weiiwang01/picard/case/PiCard-Box.step

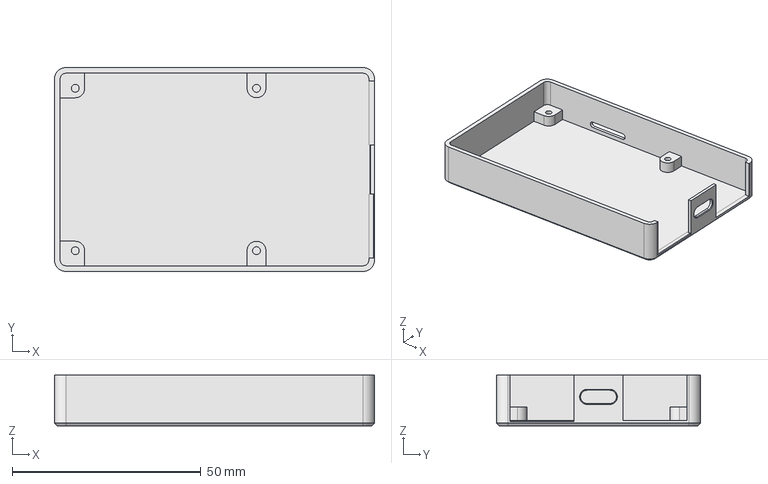
[picture p1: CAD file, 2024-05-11]
case/PiCard-Box.step
84.8 x 54.0 x 13.5 mm
