weiiwang01/picard/case/PiCard-Lid.step

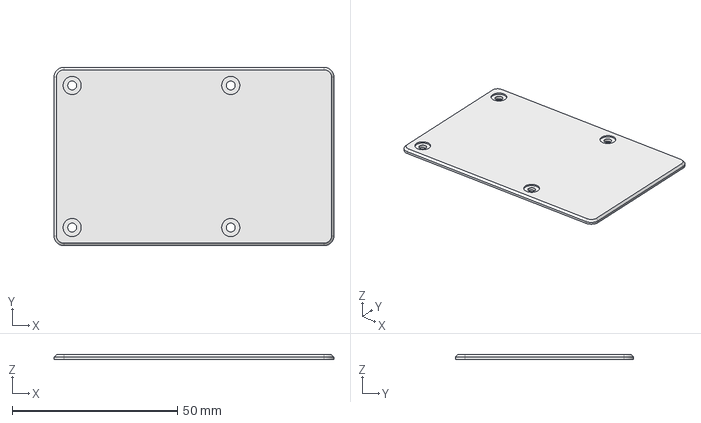
[picture p2: CAD file, 2024-05-11]
case/PiCard-Lid.step
84.8 x 54.0 x 1.50 mm
