weiiwang01/picard/case/PiCard-Box.pdf

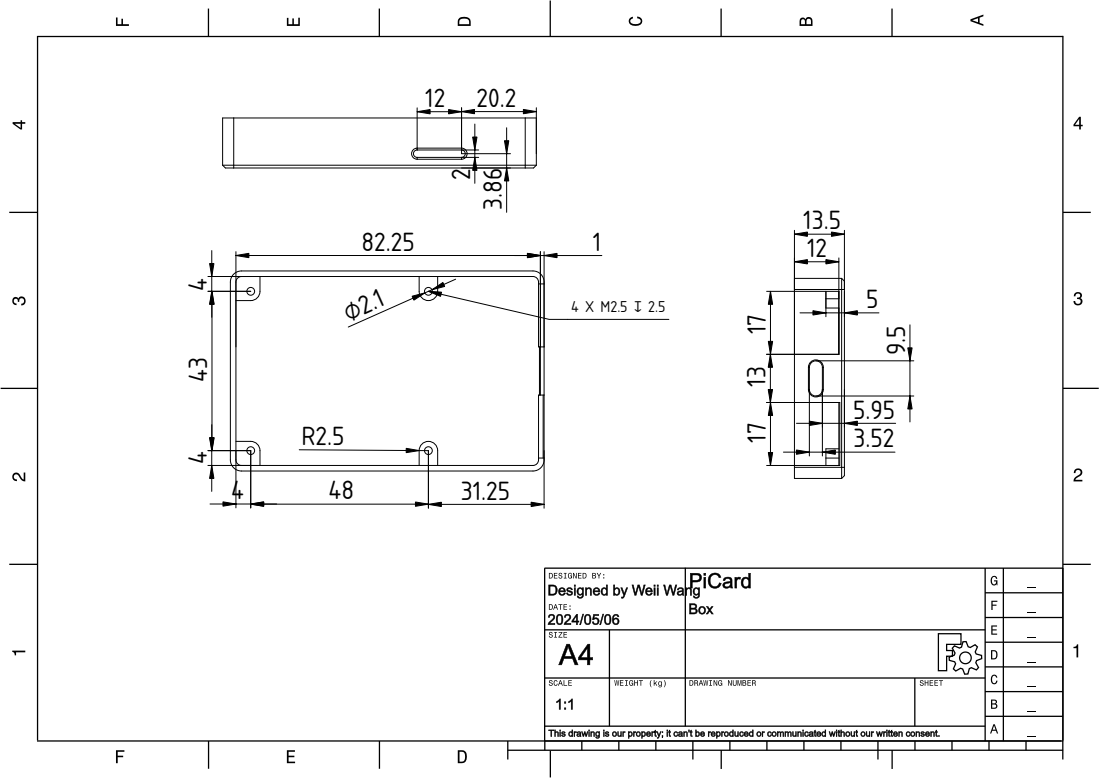
[picture p3: page 1]
