weiiwang01/picard/case/PiCard-Lid.pdf

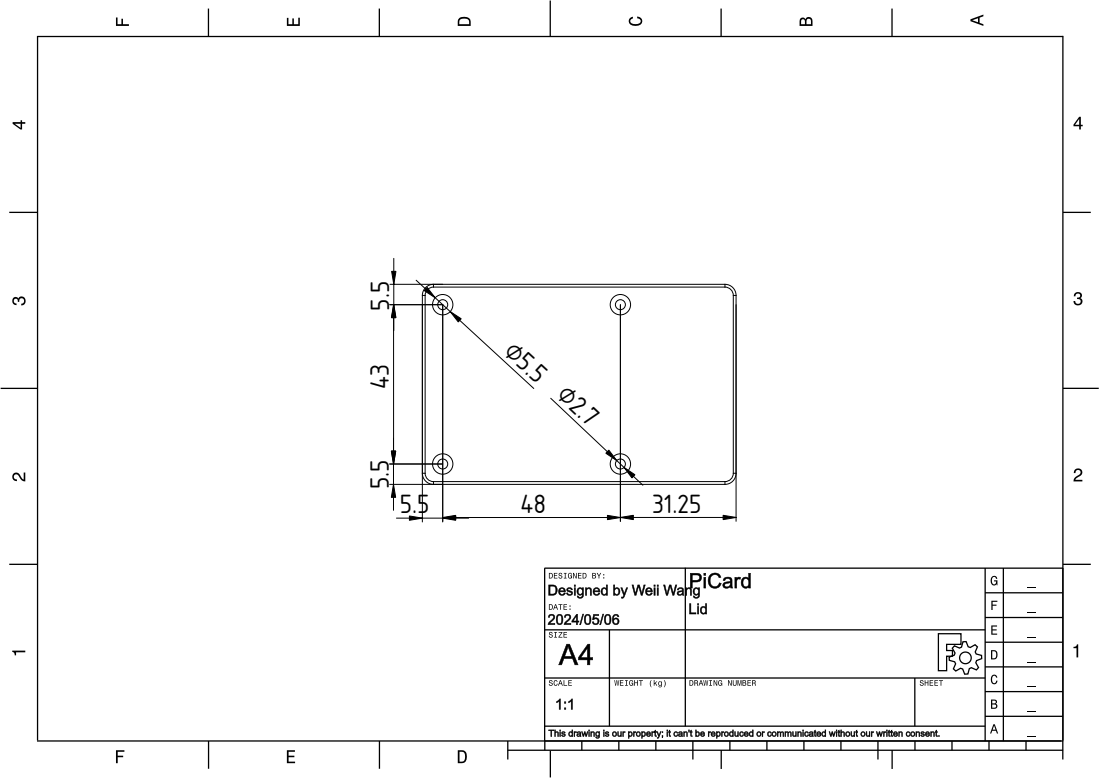
[picture p4: page 1]
