weiiwang01/picard/PiCard.kicad_pcb

## KiCad design PiCard.kicad_pcb (2024-10-13)

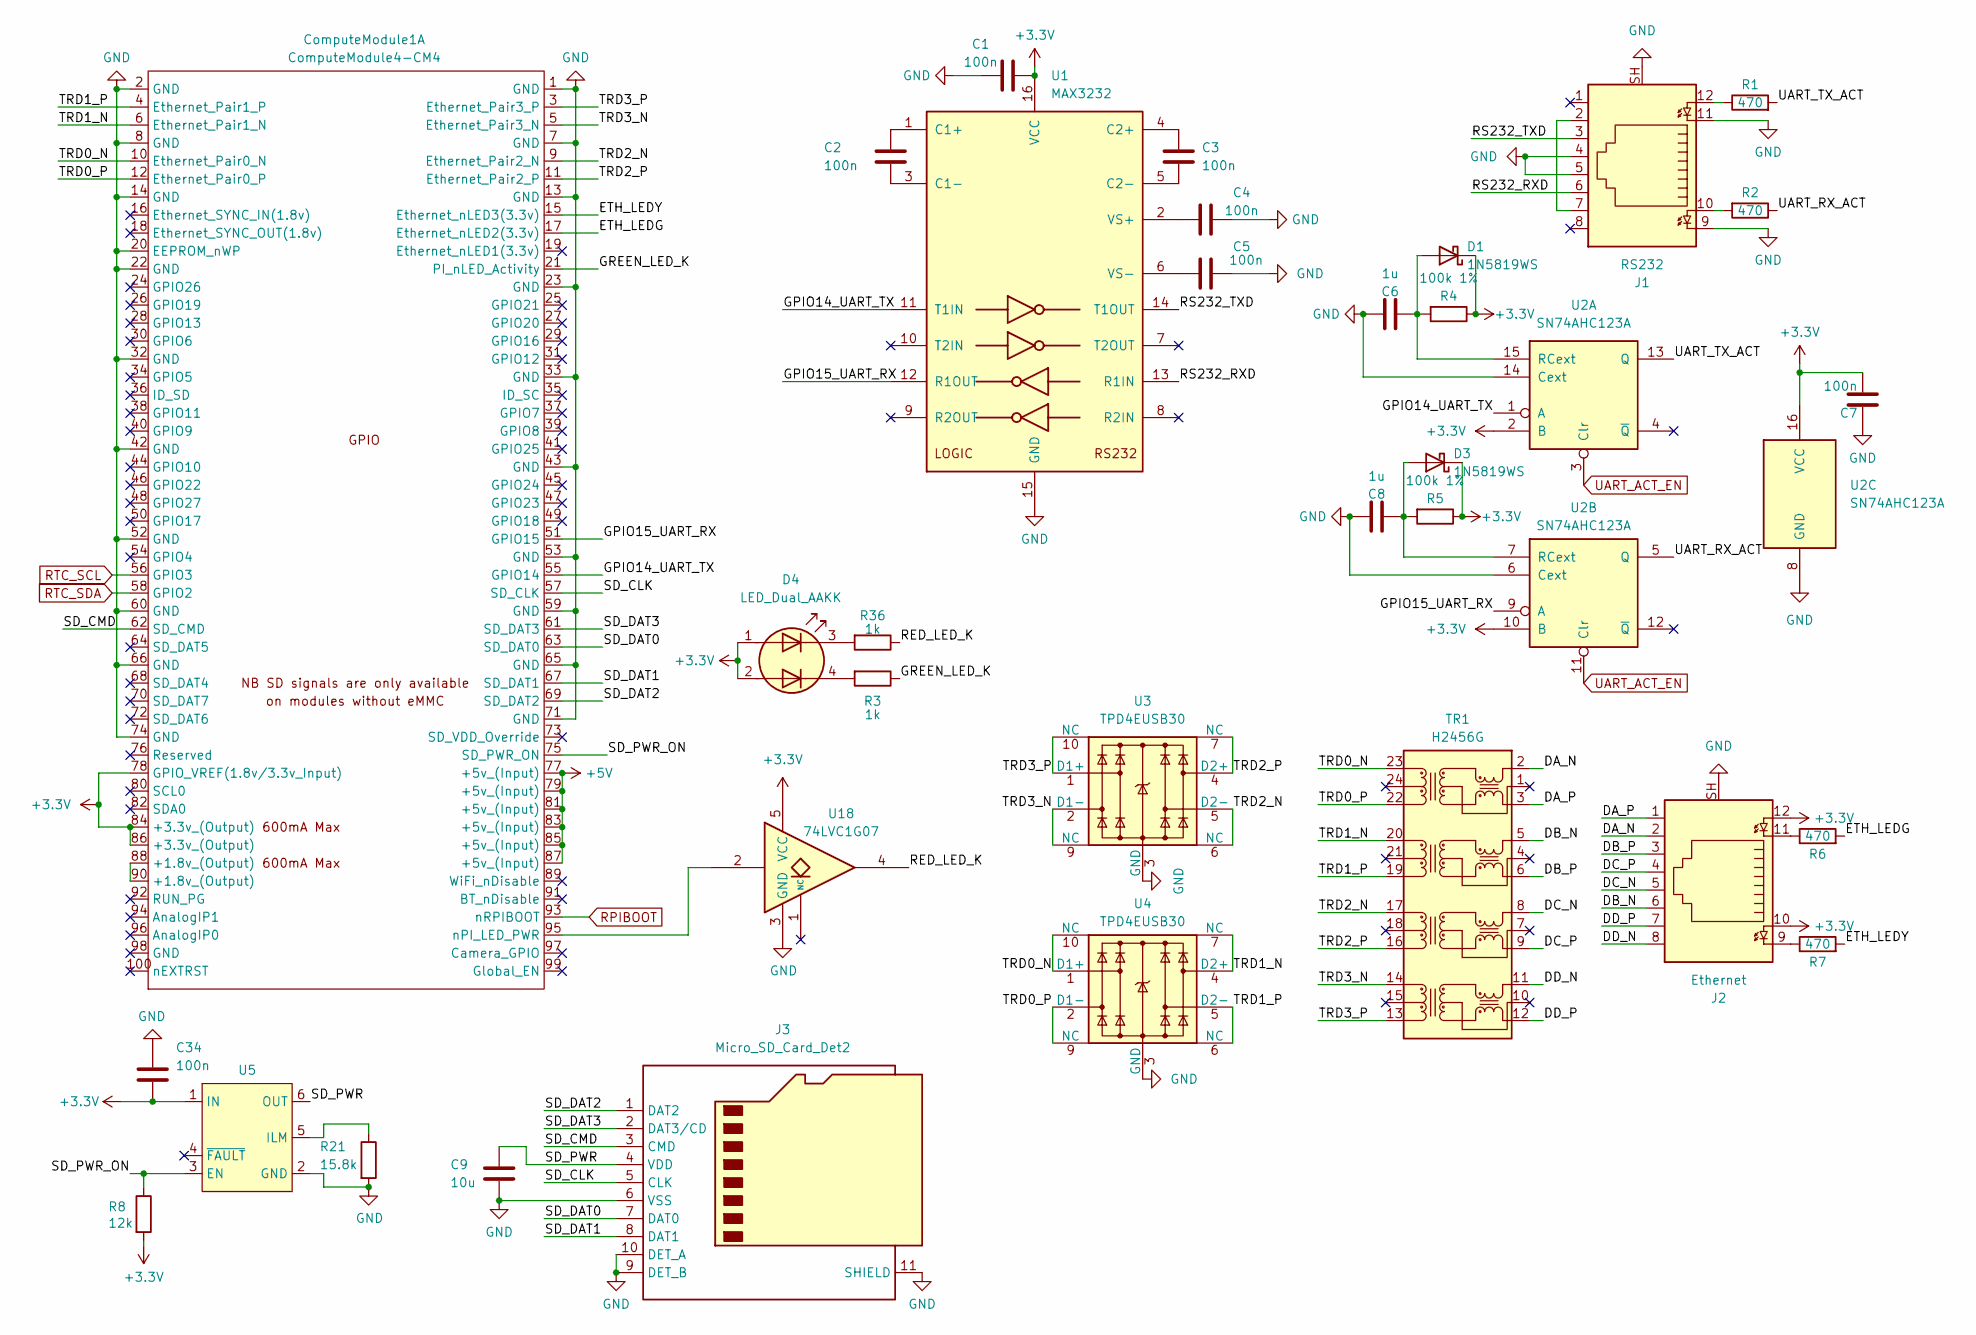
[picture p5: schematic module_a.kicad_sch]

Parts:
C1, C2, C3, C4, C5, C7, C34: 100n; C_0402_1005Metric; MPN CL05B104KB54PNC; LCSC C307331
C6, C8: 1u; C_0603_1608Metric; MPN CL10A105KB8NNNC; LCSC C15849
C9: 10u; C_0805_2012Metric; MPN CL21A106KAYNNNE; LCSC C15850
ComputeModule1: ComputeModule4-CM4; Raspberry-Pi-4-Compute-Module
D1, D3: 1N5819WS; D_SOD-323; MPN 1N5819WS; LCSC C191023
D4: LED_Dual_AAKK; LED-ARRAY-SMD_4P-L3.0-W1.5-L-FD; MPN MHS110URGCT; LCSC C473813
J1: RS232; RJ45-TH_RJ45-005-202-11; MPN RJ45-005-202-11; LCSC C501462
J2: Ethernet; RJ45-TH_RJ45-005-202-11; MPN RJ45-005-202-11; LCSC C7421405
J3: Micro_SD_Card_Det2; TF-SMD_503398-1892; MPN TF-108-ARP10; LCSC C5174683
R1, R2, R6, R7: 470; R_0402_1005Metric; MPN 0402WGF4700TCE; LCSC C25117
R3, R36: 1k; R_0402_1005Metric; MPN 0402WGF1001TCE; LCSC C11702
R4, R5: 100k 1%; R_0402_1005Metric; MPN 0402WGF1003TCE; LCSC C25741
R8: 12k; R_0402_1005Metric; MPN 0402WGF1202TCE; LCSC C25752
R21: 15.8k; R_0402_1005Metric; MPN AC0402FR-0715K8L; LCSC C226795
TR1: H2456G; XFMR-SMD-24_L16.6-W9.0-LS9.6-BL; MPN H2456G; LCSC C5464750
U1: MAX3232; TSSOP-16_4.4x5mm_P0.65mm; MPN MAX3232EEUE+T; LCSC C965425
U2: SN74AHC123A; TSSOP-16_4.4x5mm_P0.65mm; MPN SN74AHC123APWR; LCSC C2869599
U3, U4: TPD4EUSB30; USON-10_2.5x1.0mm_P0.5mm; MPN TPD4EUSB30DQAR; LCSC C90627
U5: SOT-23-6; MPN TPS2553DDBVR; LCSC C521201
U18: 74LVC1G07; SOT-353_SC-70-5; MPN SN74LVC1G07DCKR; LCSC C7830

Connections:
+3.3V: C1.2, C7.2, C34.2, ComputeModule1.78 (GPIO_VREF(1.8v/3.3v_Input)), ComputeModule1.84 (+3.3v_(Output)), ComputeModule1.86 (+3.3v_(Output)), D1.1 (K), D3.1 (K), D4.1 (A1), D4.2 (A2), J2.10, J2.12, R4.1, R5.1, R8.2, U1.16 (VCC), U2.2 (B), U2.10 (B), U2.16 (VCC), U5.1 (IN), U18.5 (VCC); also elsewhere on the board
+5V: ComputeModule1.77 (+5v_(Input)), ComputeModule1.79 (+5v_(Input)), ComputeModule1.81 (+5v_(Input)), ComputeModule1.83 (+5v_(Input)), ComputeModule1.85 (+5v_(Input)), ComputeModule1.87 (+5v_(Input)); also elsewhere on the board
/Module A/DA_N: J2.2, TR1.2 (MX1+)
/Module A/DA_P: J2.1, TR1.3 (MX1-)
/Module A/DB_N: J2.6, TR1.5 (MX2+)
/Module A/DB_P: J2.3, TR1.6 (MX2-)
/Module A/DC_N: J2.5, TR1.8 (MX3+)
/Module A/DC_P: J2.4, TR1.9 (MX3-)
/Module A/DD_N: J2.8, TR1.11 (MX4+)
/Module A/DD_P: J2.7, TR1.12 (MX4-)
/Module A/ETH_LEDG: ComputeModule1.17 (Ethernet_nLED2(3.3v)), R6.2
/Module A/ETH_LEDY: ComputeModule1.15 (Ethernet_nLED3(3.3v)), R7.2
/Module A/GPIO14_UART_TX: ComputeModule1.55 (GPIO14), U1.11 (T1IN), U2.1 (A)
/Module A/GPIO15_UART_RX: ComputeModule1.51 (GPIO15), U1.12 (R1OUT), U2.9 (A)
/Module A/GREEN_LED_K: ComputeModule1.21 (PI_nLED_Activity), R3.1
/Module A/RED_LED_K: R36.1, U18.4
/Module A/RS232_RXD: J1.6, U1.13 (R1IN)
/Module A/RS232_TXD: J1.3, U1.14 (T1OUT)
/Module A/SD_CLK: ComputeModule1.57 (SD_CLK), J3.5 (CLK)
/Module A/SD_CMD: ComputeModule1.62 (SD_CMD), J3.3 (CMD)
/Module A/SD_DAT0: ComputeModule1.63 (SD_DAT0), J3.7 (DAT0)
/Module A/SD_DAT1: ComputeModule1.67 (SD_DAT1), J3.8 (DAT1)
/Module A/SD_DAT2: ComputeModule1.69 (SD_DAT2), J3.1 (DAT2)
/Module A/SD_DAT3: ComputeModule1.61 (SD_DAT3), J3.2 (DAT3/CD)
/Module A/SD_PWR: C9.1, J3.4 (VDD), U5.6 (OUT)
/Module A/SD_PWR_ON: ComputeModule1.75 (SD_PWR_ON), R8.1, U5.3 (EN)
/Module A/TRD0_N: ComputeModule1.10 (Ethernet_Pair0_N), TR1.23 (TD1+), U4.1 (D1+), U4.10 (NC)
/Module A/TRD0_P: ComputeModule1.12 (Ethernet_Pair0_P), TR1.22 (TD1-), U4.2 (D1-), U4.9 (NC)
/Module A/TRD1_N: ComputeModule1.6 (Ethernet_Pair1_N), TR1.20 (TD2+), U4.4 (D2+), U4.7 (NC)
/Module A/TRD1_P: ComputeModule1.4 (Ethernet_Pair1_P), TR1.19 (TD2-), U4.5 (D2-), U4.6 (NC)
/Module A/TRD2_N: ComputeModule1.9 (Ethernet_Pair2_N), TR1.17, U3.5 (D2-), U3.6 (NC)
/Module A/TRD2_P: ComputeModule1.11 (Ethernet_Pair2_P), TR1.16 (TD3-), U3.4 (D2+), U3.7 (NC)
/Module A/TRD3_N: ComputeModule1.5 (Ethernet_Pair3_N), TR1.14 (TD4+), U3.2 (D1-), U3.9 (NC)
/Module A/TRD3_P: ComputeModule1.3 (Ethernet_Pair3_P), TR1.13 (TD4-), U3.1 (D1+), U3.10 (NC)
/Module A/UART_RX_ACT: R2.1, U2.5 (Q)
/Module A/UART_TX_ACT: R1.2, U2.13 (Q)
GND: C1.1, C4.2, C5.2, C6.2, C7.1, C8.2, C9.2, C34.1, ComputeModule1.1 (GND), ComputeModule1.2 (GND), ComputeModule1.7 (GND), ComputeModule1.8 (GND), ComputeModule1.13 (GND), ComputeModule1.14 (GND), ComputeModule1.20 (EEPROM_nWP), ComputeModule1.22 (GND), ComputeModule1.23 (GND), ComputeModule1.32 (GND), ComputeModule1.33 (GND), ComputeModule1.42 (GND), ComputeModule1.43 (GND), ComputeModule1.52 (GND), ComputeModule1.53 (GND), ComputeModule1.59 (GND), ComputeModule1.60 (GND), ComputeModule1.65 (GND), ComputeModule1.66 (GND), ComputeModule1.71 (GND), ComputeModule1.74 (GND), J1.4, J1.5, J1.9, J1.11, J1.SH, J2.SH, J3.6 (VSS), J3.9 (DET_B), J3.10 (DET_A), J3.11 (SHIELD), R21.2, U1.15 (GND), U2.6 (Cext), U2.8 (GND), U2.14 (Cext), U3.3 (GND), U3.8 (GND), U4.3 (GND), U4.8 (GND), U5.2 (GND), U18.3 (GND); also elsewhere on the board
unnamed: ComputeModule1.88 (+1.8v_(Output)), ComputeModule1.90 (+1.8v_(Output))
unnamed: ComputeModule1.95 (nPI_LED_PWR), U18.2
unnamed: C6.1, D1.2 (A), R4.2, U2.15 (RCext)
unnamed: C8.1, D3.2 (A), R5.2, U2.7 (RCext)
unnamed: D4.3 (K1), R36.2
unnamed: D4.4 (K2), R3.2
unnamed: J1.2, J1.7
unnamed: J1.10, R2.2
unnamed: J1.12, R1.1
unnamed: J2.9, R7.1
unnamed: J2.11, R6.1
unnamed: C2.1, U1.1 (C1+)
unnamed: C2.2, U1.3 (C1-)
unnamed: C3.1, U1.4 (C2+)
unnamed: C3.2, U1.5 (C2-)
unnamed: C4.1, U1.2 (VS+)
unnamed: C5.1, U1.6 (VS-)
unnamed: R21.1, U5.5 (ILM)
RPIBOOT: ComputeModule1.93 (nRPIBOOT); also elsewhere on the board
RTC_SCL: ComputeModule1.56 (GPIO3); also elsewhere on the board
RTC_SDA: ComputeModule1.58 (GPIO2); also elsewhere on the board
UART_ACT_EN: U2.3 (Clr), U2.11 (Clr); also elsewhere on the board

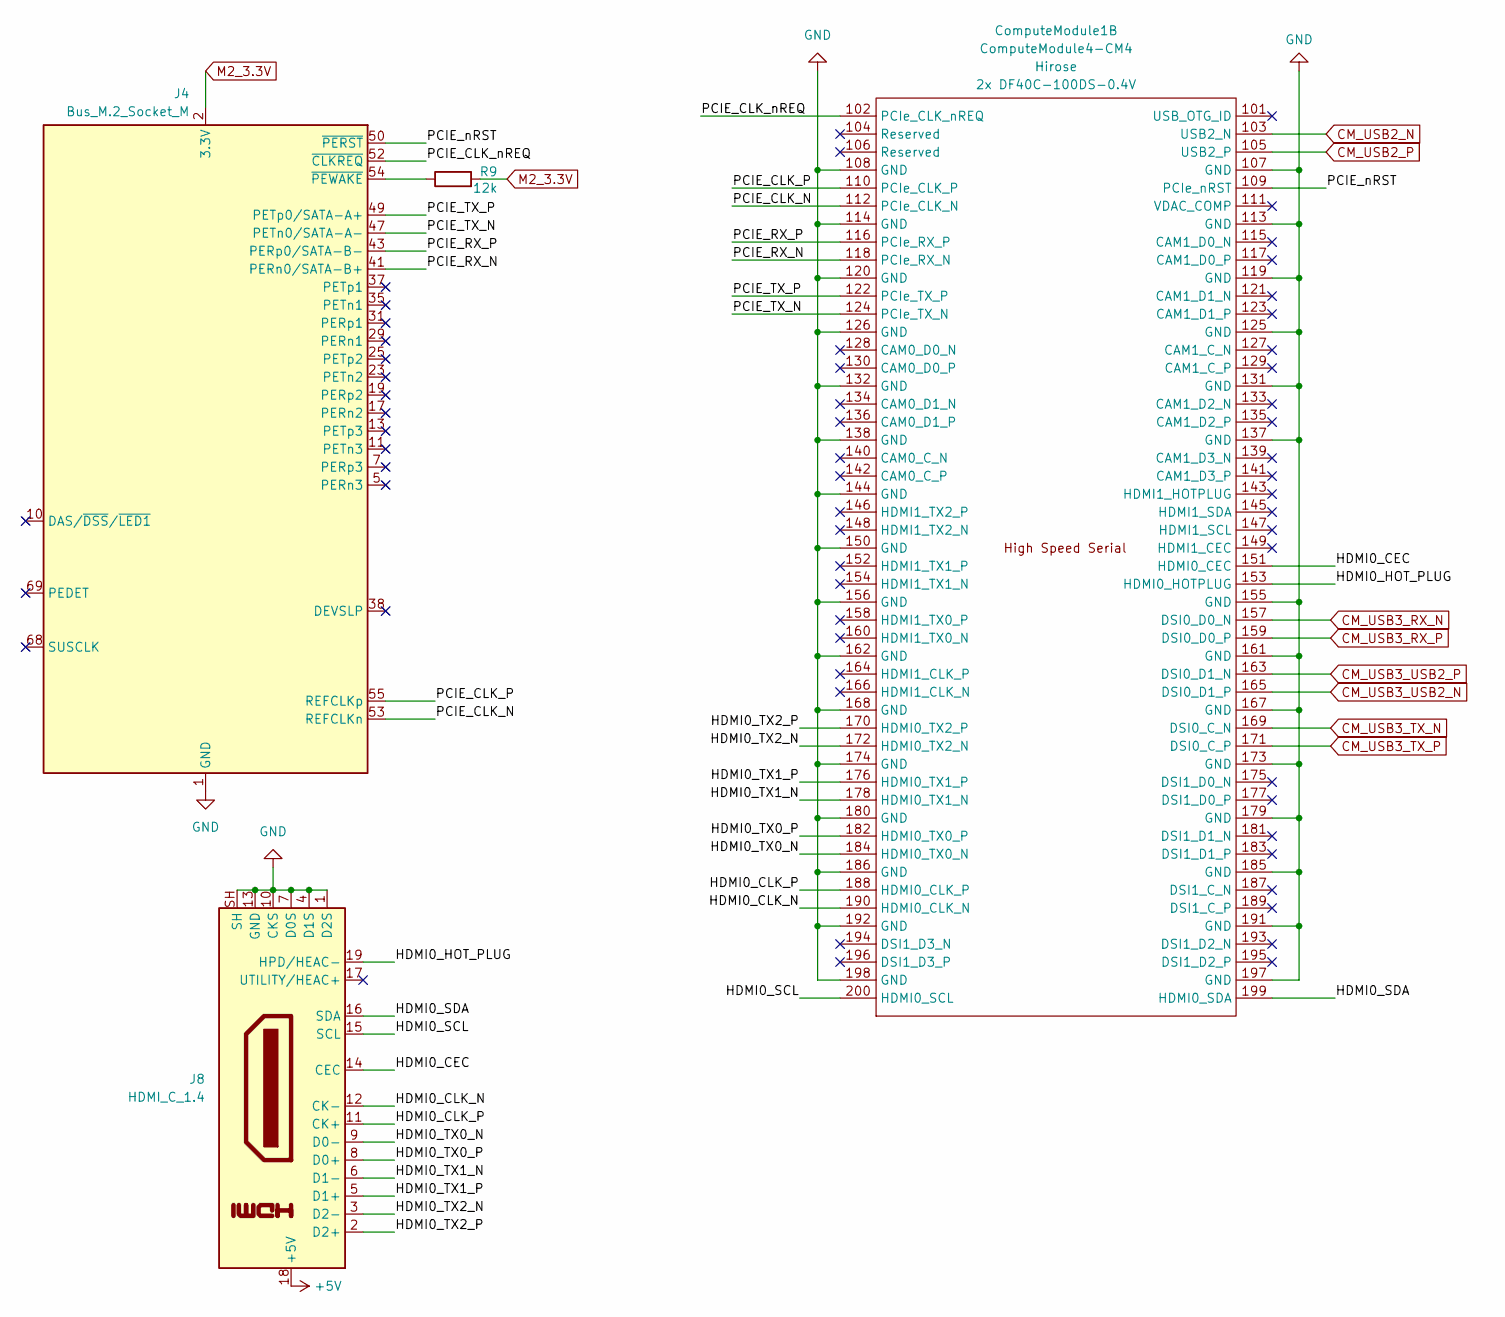
[picture p6: schematic module_b.kicad_sch]

Parts:
ComputeModule1: ComputeModule4-CM4; Raspberry-Pi-4-Compute-Module
J4: Bus_M.2_Socket_M; CONN-SMD_APCI0146-P001A; MPN APCI0146-P001A; LCSC C841645
J8: HDMI_C_1.4; HDMI-SMD_19P-P0.40-H-F_HDMI-519S; MPN HDMI-519S; LCSC C183605
R9: 12k; R_0402_1005Metric; MPN 0402WGF1202TCE; LCSC C25752

Connections:
+5V: J8.18 (+5V); also elsewhere on the board
/Module B/HDMI0_CEC: ComputeModule1.151 (HDMI0_CEC), J8.14 (CEC)
/Module B/HDMI0_CLK_N: ComputeModule1.190 (HDMI0_CLK_N), J8.12 (CK-)
/Module B/HDMI0_CLK_P: ComputeModule1.188 (HDMI0_CLK_P), J8.11 (CK+)
/Module B/HDMI0_HOT_PLUG: ComputeModule1.153 (HDMI0_HOTPLUG), J8.19 (HPD/HEAC-)
/Module B/HDMI0_SCL: ComputeModule1.200 (HDMI0_SCL), J8.15 (SCL)
/Module B/HDMI0_SDA: ComputeModule1.199 (HDMI0_SDA), J8.16 (SDA)
/Module B/HDMI0_TX0_N: ComputeModule1.184 (HDMI0_TX0_N), J8.9 (D0-)
/Module B/HDMI0_TX0_P: ComputeModule1.182 (HDMI0_TX0_P), J8.8 (D0+)
/Module B/HDMI0_TX1_N: ComputeModule1.178 (HDMI0_TX1_N), J8.6 (D1-)
/Module B/HDMI0_TX1_P: ComputeModule1.176 (HDMI0_TX1_P), J8.5 (D1+)
/Module B/HDMI0_TX2_N: ComputeModule1.172 (HDMI0_TX2_N), J8.3 (D2-)
/Module B/HDMI0_TX2_P: ComputeModule1.170 (HDMI0_TX2_P), J8.2 (D2+)
/Module B/PCIE_CLK_N: ComputeModule1.112 (PCIe_CLK_N), J4.53 (REFCLKn)
/Module B/PCIE_CLK_P: ComputeModule1.110 (PCIe_CLK_P), J4.55 (REFCLKp)
/Module B/PCIE_CLK_nREQ: ComputeModule1.102 (PCIe_CLK_nREQ), J4.52 (~CLKREQ)
/Module B/PCIE_RX_N: ComputeModule1.118 (PCIe_RX_N), J4.41 (PERn0/SATA-B+)
/Module B/PCIE_RX_P: ComputeModule1.116 (PCIe_RX_P), J4.43 (PERp0/SATA-B-)
/Module B/PCIE_TX_N: ComputeModule1.124 (PCIe_TX_N), J4.47 (PETn0/SATA-A-)
/Module B/PCIE_TX_P: ComputeModule1.122 (PCIe_TX_P), J4.49 (PETp0/SATA-A+)
/Module B/PCIE_nRST: ComputeModule1.109 (PCIe_nRST), J4.50 (~PERST)
CM_USB2_N: ComputeModule1.103 (USB2_N); also elsewhere on the board
CM_USB2_P: ComputeModule1.105 (USB2_P); also elsewhere on the board
CM_USB3_RX_N: ComputeModule1.157 (DSI0_D0_N); also elsewhere on the board
CM_USB3_RX_P: ComputeModule1.159 (DSI0_D0_P); also elsewhere on the board
CM_USB3_TX_N: ComputeModule1.169 (DSI0_C_N); also elsewhere on the board
CM_USB3_TX_P: ComputeModule1.171 (DSI0_C_P); also elsewhere on the board
CM_USB3_USB2_N: ComputeModule1.165 (DSI0_D1_P); also elsewhere on the board
CM_USB3_USB2_P: ComputeModule1.163 (DSI0_D1_N); also elsewhere on the board
GND: ComputeModule1.107 (GND), ComputeModule1.108 (GND), ComputeModule1.113 (GND), ComputeModule1.114 (GND), ComputeModule1.119 (GND), ComputeModule1.120 (GND), ComputeModule1.125 (GND), ComputeModule1.126 (GND), ComputeModule1.131 (GND), ComputeModule1.132 (GND), ComputeModule1.137 (GND), ComputeModule1.138 (GND), ComputeModule1.144 (GND), ComputeModule1.150 (GND), ComputeModule1.155 (GND), ComputeModule1.156 (GND), ComputeModule1.161 (GND), ComputeModule1.162 (GND), ComputeModule1.167 (GND), ComputeModule1.168 (GND), ComputeModule1.173 (GND), ComputeModule1.174 (GND), ComputeModule1.179 (GND), ComputeModule1.180 (GND), ComputeModule1.185 (GND), ComputeModule1.186 (GND), ComputeModule1.191 (GND), ComputeModule1.192 (GND), ComputeModule1.197 (GND), ComputeModule1.198 (GND), J4.1 (GND), J4.3 (GND), J4.9 (GND), J4.15 (GND), J4.21 (GND), J4.27 (GND), J4.33 (GND), J4.39 (GND), J4.45 (GND), J4.51 (GND), J4.57 (GND), J4.71 (GND), J4.73 (GND), J4.75 (GND), J8.1 (D2S), J8.4 (D1S), J8.7 (D0S), J8.10 (CKS), J8.13 (GND), J8.SH; also elsewhere on the board
M2_3.3V: J4.2 (3.3V), J4.4 (3.3V), J4.12 (3.3V), J4.14 (3.3V), J4.16 (3.3V), J4.18 (3.3V), J4.70 (3.3V), J4.72 (3.3V), J4.74 (3.3V), R9.2; also elsewhere on the board
unnamed: J4.54 (~PEWAKE), R9.1

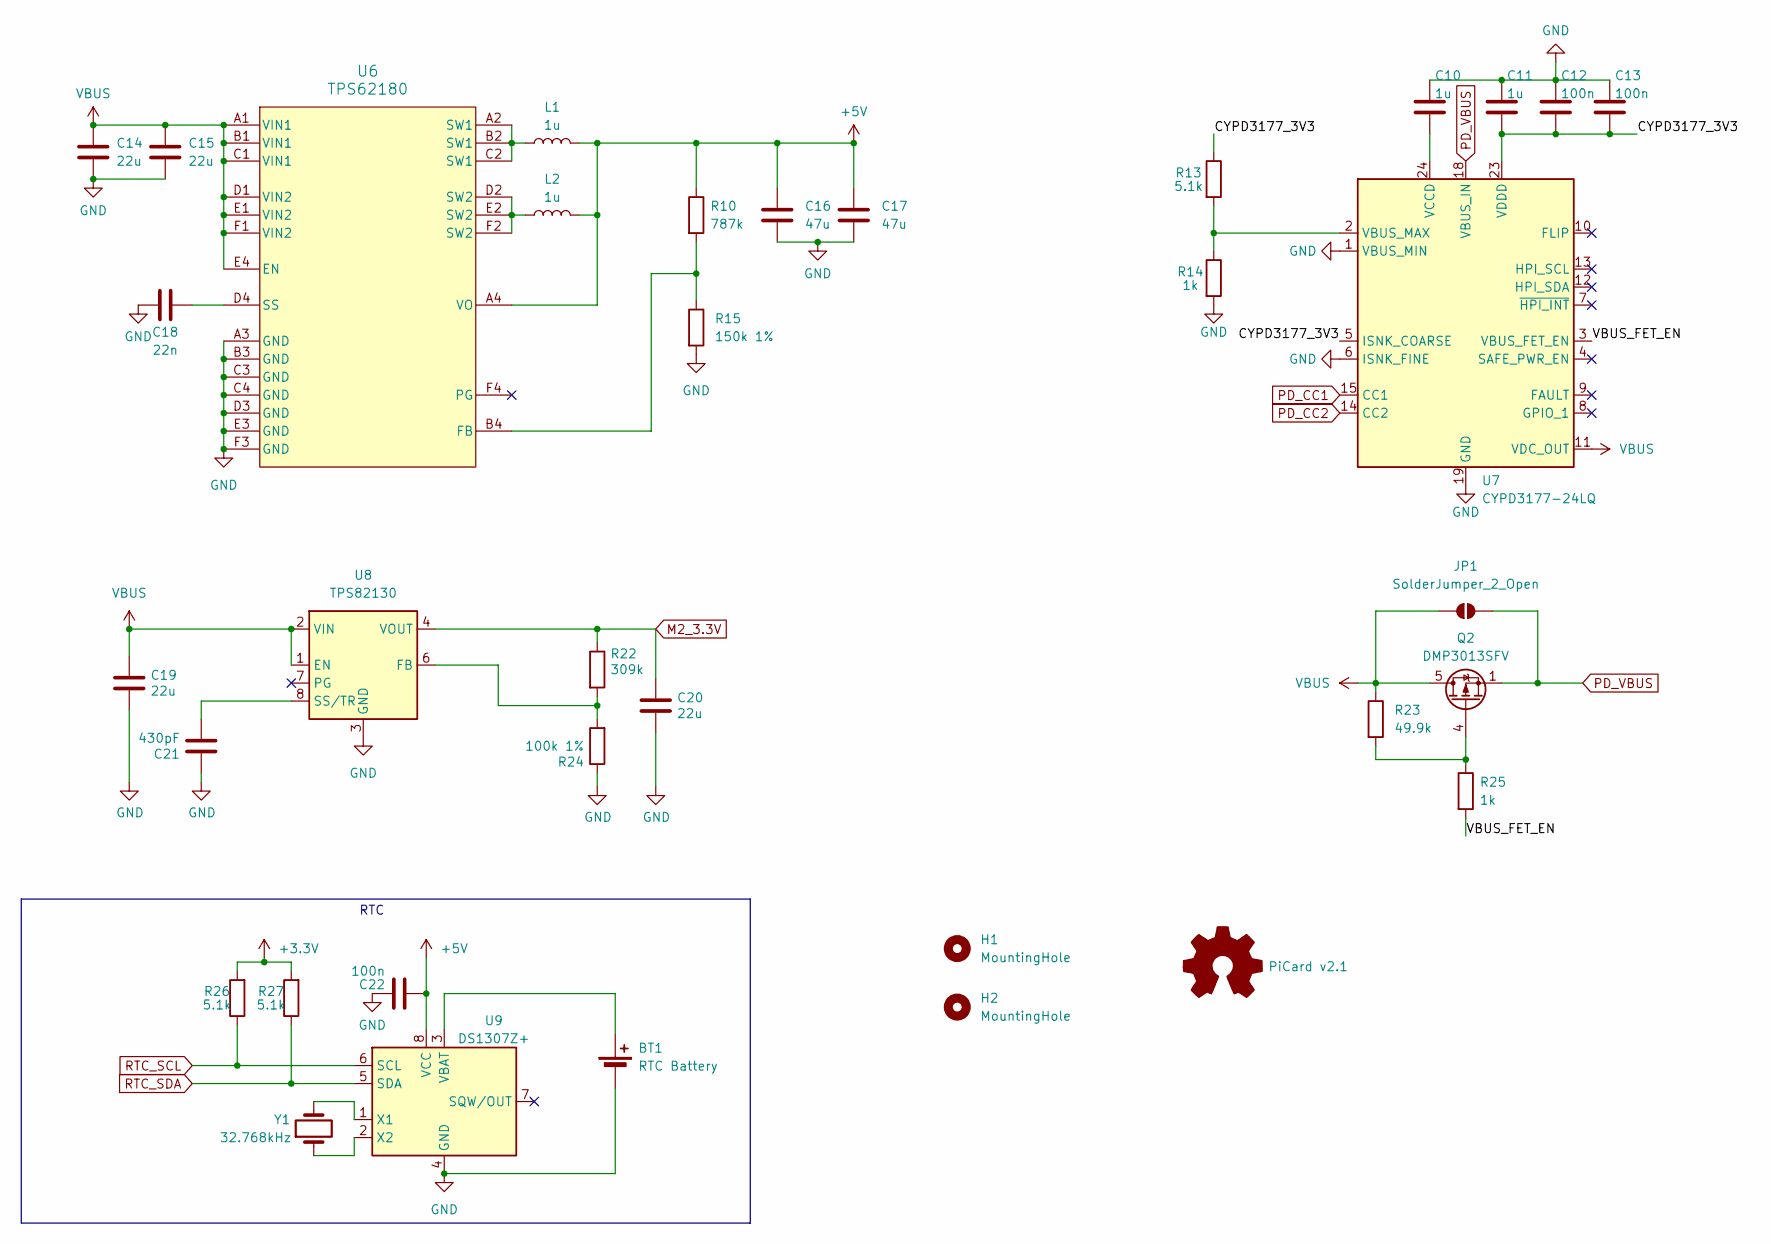
[picture p7: schematic Power.kicad_sch]

Parts:
BT1: RTC Battery; BAT-SMD_MY-1220-03; MPN MY-1220-04; LCSC C2979172
C10, C11: 1u; C_0603_1608Metric; MPN CL10A105KB8NNNC; LCSC C15849
C12, C13, C22: 100n; C_0402_1005Metric; MPN CL05B104KB54PNC; LCSC C307331
C14, C15, C19, C20: 22u; C_0805_2012Metric; MPN CL21A226MAQNNNE; LCSC C45783
C16, C17: 47u; C_0805_2012Metric; MPN CL21A476MQYNNNE; LCSC C16780
C18: 22n; C_0603_1608Metric; MPN CL10B223KB8NNNC; LCSC C21122
C21: 430pF; C_0402_1005Metric; MPN CC0603FRNPO9BN431; LCSC C519571
H1, H2: MountingHole; MOUNTING-HOLE
JP1: SolderJumper_2_Open; SolderJumper-2_P1.3mm_Open_TrianglePad1.0x1.5mm
L1, L2: 1u; L_1008_2520Metric; MPN DFE252012F-1R0M=P2; LCSC C435392
Q2: DMP3013SFV; Diodes_PowerDI3333-8; MPN DMP3013SFV-7; LCSC C264098
R10: 787k; R_0402_1005Metric; MPN RTT027873FTH; LCSC C158978
R13, R26, R27: 5.1k; R_0402_1005Metric; MPN 0402WGF5101TCE; LCSC C25905
R14, R25: 1k; R_0402_1005Metric; MPN 0402WGF1001TCE; LCSC C11702
R15: 150k 1%; R_0402_1005Metric; MPN 0402WGF1503TCE; LCSC C25755
R22: 309k; R_0402_1005Metric; MPN RTT023093FTH; LCSC C159040
R23: 49.9k; R_0402_1005Metric; MPN 0402WGF4992TCE; LCSC C25897
R24: 100k 1%; R_0402_1005Metric; MPN 0402WGF1003TCE; LCSC C25741
SYM1: PiCard v2.1; PICARD_NAMEPLATE
U6: TPS62180; YZF0024AMAM; MPN TPS62180YZFR; LCSC C2071394
U7: CYPD3177-24LQ; QFN-24-1EP_4x4mm_P0.5mm_EP2.75x2.75mm; MPN CYPD3177-24LQXQ; LCSC C2959321
U8: TPS82130; Texas_SIL0008D_MicroSiP-8-1EP_2.8x3mm_P0.65mm_EP1.1x1.9mm_T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; MPN TPS82130SILR; LCSC C473914
U9: DS1307Z+; SOIC-8_3.9x4.9mm_P1.27mm; MPN DS1307IDRG; LCSC C5145428
Y1: 32.768kHz; Crystal_SMD_3215-2Pin_3.2x1.5mm; MPN Q13FC13500004; LCSC C32346

Connections:
+3.3V: R26.2, R27.2; also elsewhere on the board
+5V: C16.1, C17.1, C22.2, L1.2, L2.2, R10.1, U6.A4 (VO), U9.8 (VCC); also elsewhere on the board
/Power/CYPD3177_3V3: C11.2, C12.2, C13.2, R13.1, U7.5 (ISNK_COARSE), U7.23 (VDDD)
/Power/VBUS_FET_EN: R25.2, U7.3 (VBUS_FET_EN)
GND: BT1.2 (-), C10.1, C11.1, C12.1, C13.1, C14.2, C15.2, C16.2, C17.2, C18.2, C19.2, C20.2, C21.1, C22.1, R14.2, R15.2, R24.1, U6.A3 (GND), U6.B3 (GND), U6.C3 (GND), U6.C4 (GND), U6.D3 (GND), U6.E3 (GND), U6.F3 (GND), U7.1 (VBUS_MIN), U7.6 (ISNK_FINE), U7.19 (GND), U7.22 (GND), U7.25 (GND), U8.3 (GND), U8.9 (GND), U9.4 (GND); also elsewhere on the board
M2_3.3V: C20.1, R22.1, U8.4 (VOUT), U8.5 (VOUT); also elsewhere on the board
unnamed: BT1.1 (+), U9.3 (VBAT)
unnamed: L1.1, U6.A2 (SW1), U6.B2 (SW1), U6.C2 (SW1)
unnamed: L2.1, U6.D2 (SW2), U6.E2 (SW2), U6.F2 (SW2)
unnamed: Q2.4 (G), R23.2, R25.1
unnamed: R10.2, R15.1, U6.B4 (FB)
unnamed: C18.1, U6.D4 (SS)
unnamed: R13.2, R14.1, U7.2 (VBUS_MAX)
unnamed: C10.2, U7.24 (VCCD)
unnamed: R22.2, R24.2, U8.6 (FB)
unnamed: C21.2, U8.8 (SS/TR)
unnamed: U9.1 (X1), Y1.2
unnamed: U9.2 (X2), Y1.1
PD_CC1: U7.15 (CC1); also elsewhere on the board
PD_CC2: U7.14 (CC2); also elsewhere on the board
PD_VBUS: JP1.2 (B), Q2.1 (S), Q2.2 (S), Q2.3 (S), U7.18 (VBUS_IN); also elsewhere on the board
RTC_SCL: R26.1, U9.6 (SCL); also elsewhere on the board
RTC_SDA: R27.1, U9.5 (SDA); also elsewhere on the board
VBUS: C14.1, C15.1, C19.1, JP1.1 (A), Q2.5 (D), R23.1, U6.A1 (VIN1), U6.B1 (VIN1), U6.C1 (VIN1), U6.D1 (VIN2), U6.E1 (VIN2), U6.E4 (EN), U6.F1 (VIN2), U7.11 (VDC_OUT), U8.1 (EN), U8.2 (VIN)

Notes on the sheet:
RTC

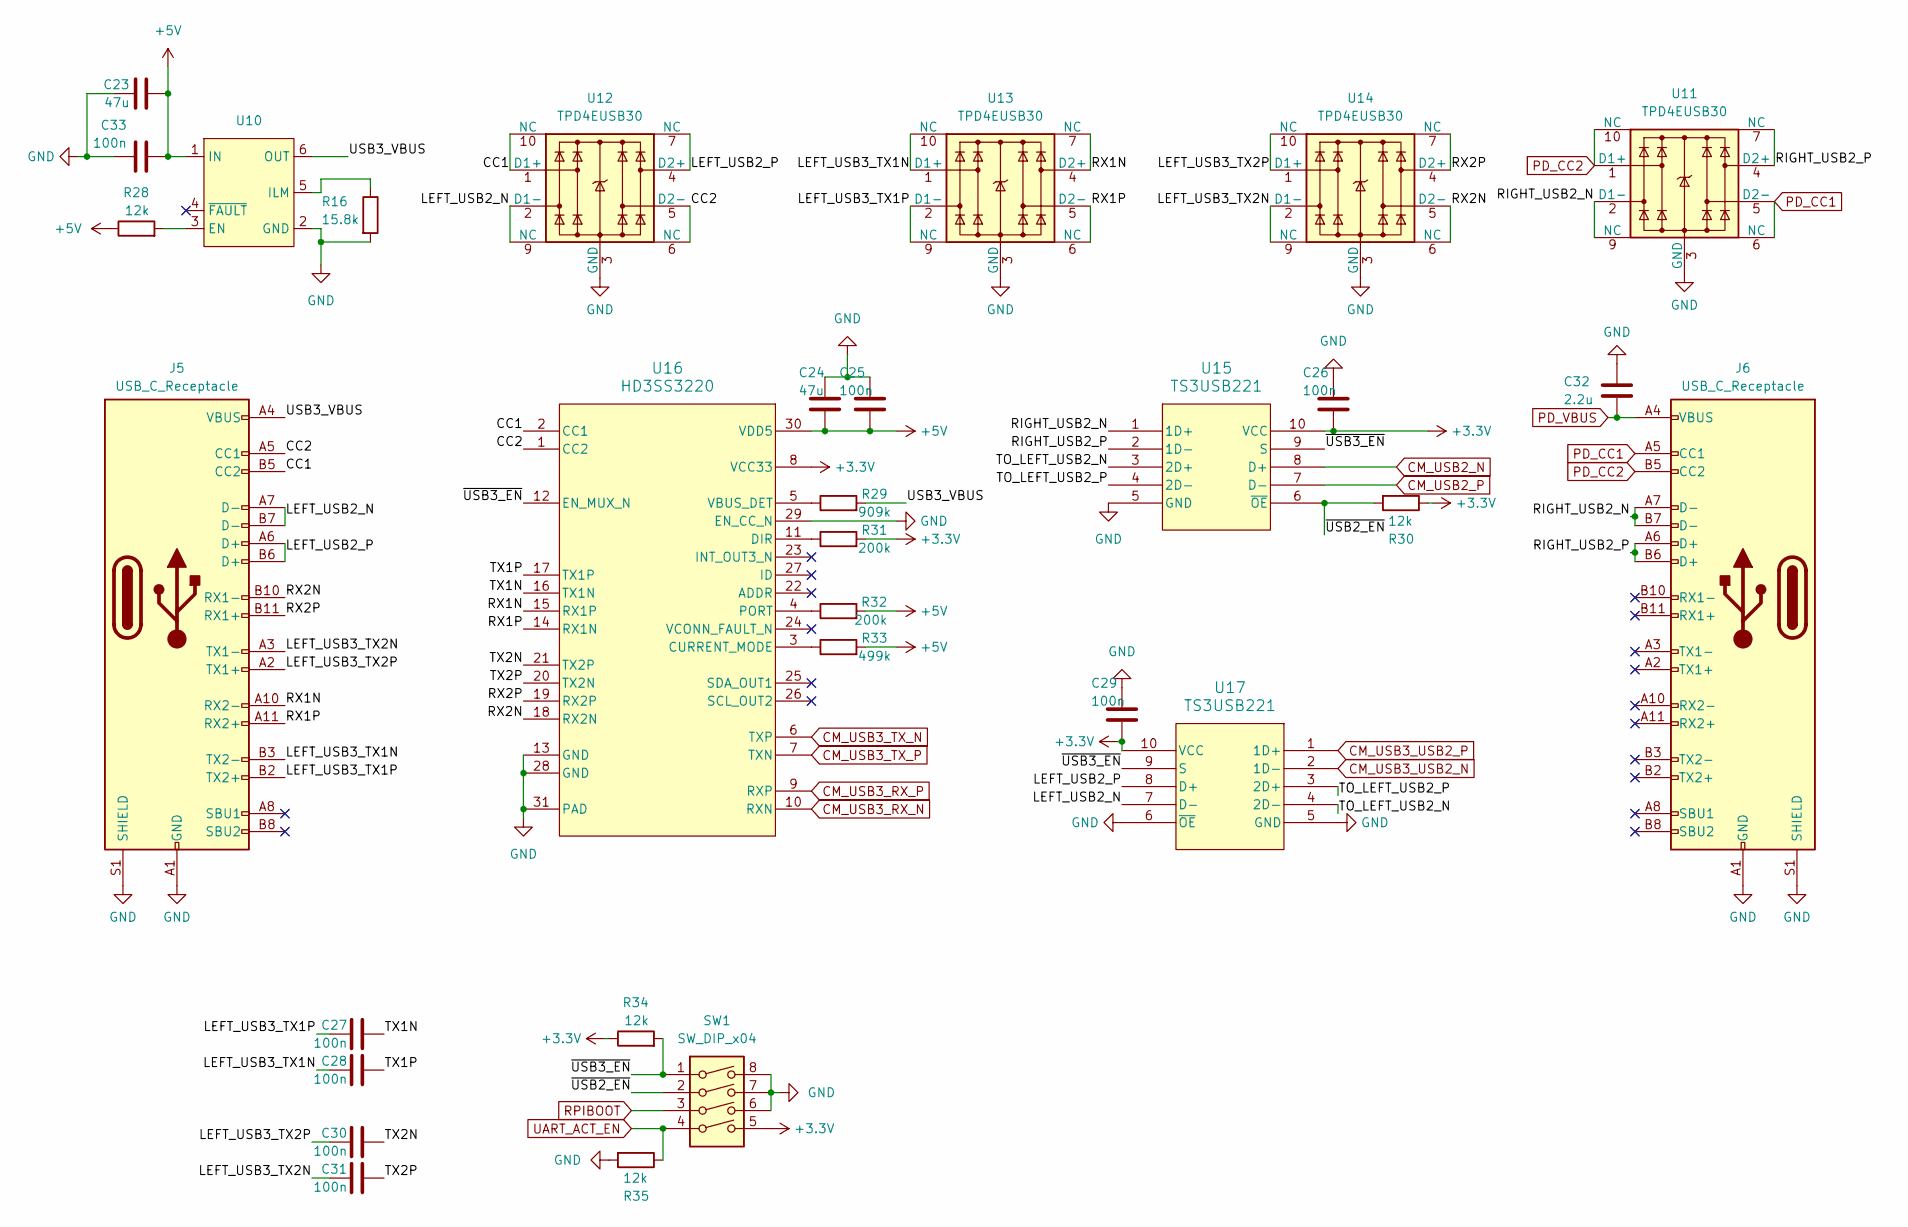
[picture p8: schematic USB.kicad_sch]

Parts:
C23, C24: 47u; C_0805_2012Metric; MPN CL21A476MQYNNNE; LCSC C16780
C25, C26, C27, C28, C29, C30, C31, C33: 100n; C_0402_1005Metric; MPN CL05B104KB54PNC; LCSC C307331
C32: 2.2u; C_1206_3216Metric; MPN CL31B225KBHNNNE; LCSC C50254
J5, J6: USB_C_Receptacle; USB-C-SMD_TYPE-C-31-M-27; MPN TYPE-C-31-M-27; LCSC C707318
R16: 15.8k; R_0402_1005Metric; MPN AC0402FR-0715K8L; LCSC C226795
R28, R30, R34, R35: 12k; R_0402_1005Metric; MPN 0402WGF1202TCE; LCSC C25752
R29: 909k; R_0402_1005Metric; MPN ERJ2RKF9093X; LCSC C2085054
R31, R32: 200k; R_0402_1005Metric; MPN 0402WGF2003TCE; LCSC C25764
R33: 499k; R_0402_1005Metric; MPN RC0402FR-07499KL; LCSC C137971
SW1: SW_DIP_x04; SW-SMD_8P-P1.27_EU-04KS; MPN EU-04KS; LCSC C2931170
U10: SOT-23-6; MPN TPS2553DDBVR; LCSC C521201
U11, U12, U13, U14: TPD4EUSB30; USON-10_2.5x1.0mm_P0.5mm; MPN TPD4EUSB30DQAR; LCSC C90627
U15, U17: TS3USB221; Texas_UQFN-10_1.5x2mm_P0.5mm; MPN TS3USB221RSER; LCSC C130085
U16: HD3SS3220; RNH0030A; MPN HD3SS3220RNHR; LCSC C165155

Connections:
+3.3V: C26.2, C29.2, R30.1, R31.2, R34.1, SW1.5, U15.10 (VCC), U16.8 (VCC33), U17.10 (VCC); also elsewhere on the board
+5V: C23.2, C24.2, C25.2, C33.2, R28.1, R32.2, R33.2, U10.1 (IN), U16.30 (VDD5); also elsewhere on the board
/USB/CC1: J5.B5 (CC2), U12.1 (D1+), U12.10 (NC), U16.2 (CC1)
/USB/CC2: J5.A5 (CC1), U12.5 (D2-), U12.6 (NC), U16.1 (CC2)
/USB/LEFT_USB2_N: J5.A7 (D-), J5.B7 (D-), U12.2 (D1-), U12.9 (NC), U17.7 (D-)
/USB/LEFT_USB2_P: J5.A6 (D+), J5.B6 (D+), U12.4 (D2+), U12.7 (NC), U17.8 (D+)
/USB/LEFT_USB3_TX1N: C28.1, J5.B3 (TX2-), U13.1 (D1+), U13.10 (NC)
/USB/LEFT_USB3_TX1P: C27.1, J5.B2 (TX2+), U13.2 (D1-), U13.9 (NC)
/USB/LEFT_USB3_TX2N: C31.1, J5.A3 (TX1-), U14.2 (D1-), U14.9 (NC)
/USB/LEFT_USB3_TX2P: C30.1, J5.A2 (TX1+), U14.1 (D1+), U14.10 (NC)
/USB/RIGHT_USB2_N: J6.A7 (D-), J6.B7 (D-), U11.2 (D1-), U11.9 (NC), U15.1 (1D+)
/USB/RIGHT_USB2_P: J6.A6 (D+), J6.B6 (D+), U11.4 (D2+), U11.7 (NC), U15.2 (1D-)
/USB/RX1N: J5.A10 (RX2-), U13.4 (D2+), U13.7 (NC), U16.15 (RX1P)
/USB/RX1P: J5.A11 (RX2+), U13.5 (D2-), U13.6 (NC), U16.14 (RX1N)
/USB/RX2N: J5.B10 (RX1-), U14.5 (D2-), U14.6 (NC), U16.18 (RX2N)
/USB/RX2P: J5.B11 (RX1+), U14.4 (D2+), U14.7 (NC), U16.19 (RX2P)
/USB/TO_LEFT_USB2_N: U15.3 (2D+), U17.4 (2D-)
/USB/TO_LEFT_USB2_P: U15.4 (2D-), U17.3 (2D+)
/USB/TX1N: C27.2, U16.16 (TX1N)
/USB/TX1P: C28.2, U16.17 (TX1P)
/USB/TX2N: C30.2, U16.21 (TX2P)
/USB/TX2P: C31.2, U16.20 (TX2N)
/USB/USB3_VBUS: J5.A4 (VBUS), J5.A9 (VBUS), J5.B4 (VBUS), J5.B9 (VBUS), R29.2, U10.6 (OUT)
/USB/~USB2_EN: R30.2, SW1.2, U15.6 (~OE)
/USB/~USB3_EN: R34.2, SW1.1, U15.9 (S), U16.12 (EN_MUX_N), U17.9 (S)
CM_USB2_N: U15.8 (D+); also elsewhere on the board
CM_USB2_P: U15.7 (D-); also elsewhere on the board
CM_USB3_RX_N: U16.10 (RXN); also elsewhere on the board
CM_USB3_RX_P: U16.9 (RXP); also elsewhere on the board
CM_USB3_TX_N: U16.6 (TXP); also elsewhere on the board
CM_USB3_TX_P: U16.7 (TXN); also elsewhere on the board
CM_USB3_USB2_N: U17.2 (1D-); also elsewhere on the board
CM_USB3_USB2_P: U17.1 (1D+); also elsewhere on the board
GND: C23.1, C24.1, C25.1, C26.1, C29.1, C32.1, C33.1, J5.A1 (GND), J5.A12 (GND), J5.B1 (GND), J5.B12 (GND), J5.S1 (SHIELD), J6.A1 (GND), J6.A12 (GND), J6.B1 (GND), J6.B12 (GND), J6.S1 (SHIELD), R16.2, R35.2, SW1.6, SW1.7, SW1.8, U10.2 (GND), U11.3 (GND), U11.8 (GND), U12.3 (GND), U12.8 (GND), U13.3 (GND), U13.8 (GND), U14.3 (GND), U14.8 (GND), U15.5 (GND), U16.13 (GND), U16.28 (GND), U16.29 (EN_CC_N), U16.31 (PAD), U17.5 (GND), U17.6 (~OE); also elsewhere on the board
unnamed: R28.2, U10.3 (EN)
unnamed: R16.1, U10.5 (ILM)
unnamed: R33.1, U16.3 (CURRENT_MODE)
unnamed: R31.1, U16.11 (DIR)
unnamed: R32.1, U16.4 (PORT)
unnamed: R29.1, U16.5 (VBUS_DET)
PD_CC1: J6.A5 (CC1), U11.5 (D2-), U11.6 (NC); also elsewhere on the board
PD_CC2: J6.B5 (CC2), U11.1 (D1+), U11.10 (NC); also elsewhere on the board
PD_VBUS: C32.2, J6.A4 (VBUS), J6.A9 (VBUS), J6.B4 (VBUS), J6.B9 (VBUS); also elsewhere on the board
RPIBOOT: SW1.3; also elsewhere on the board
UART_ACT_EN: R35.1, SW1.4; also elsewhere on the board

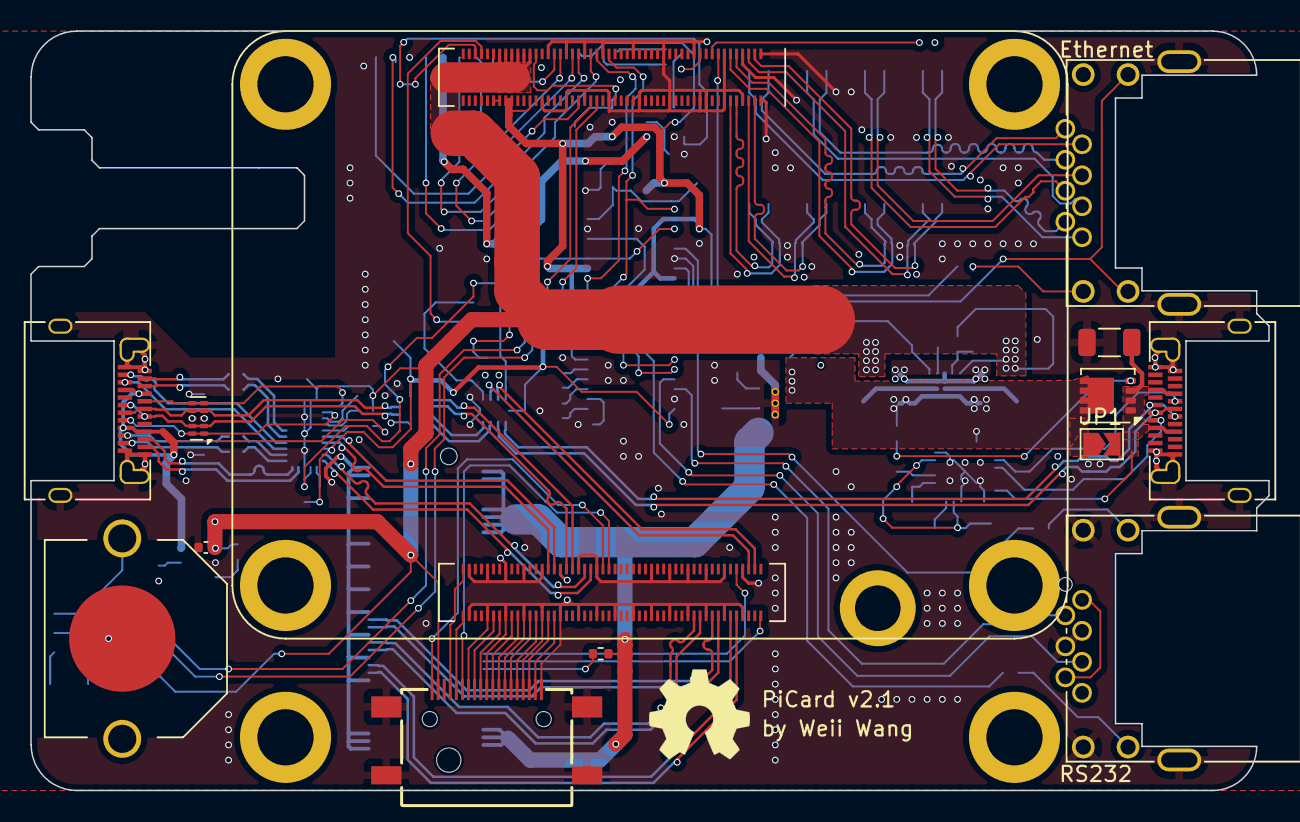
[picture p9: board PiCard.kicad_pcb from above]

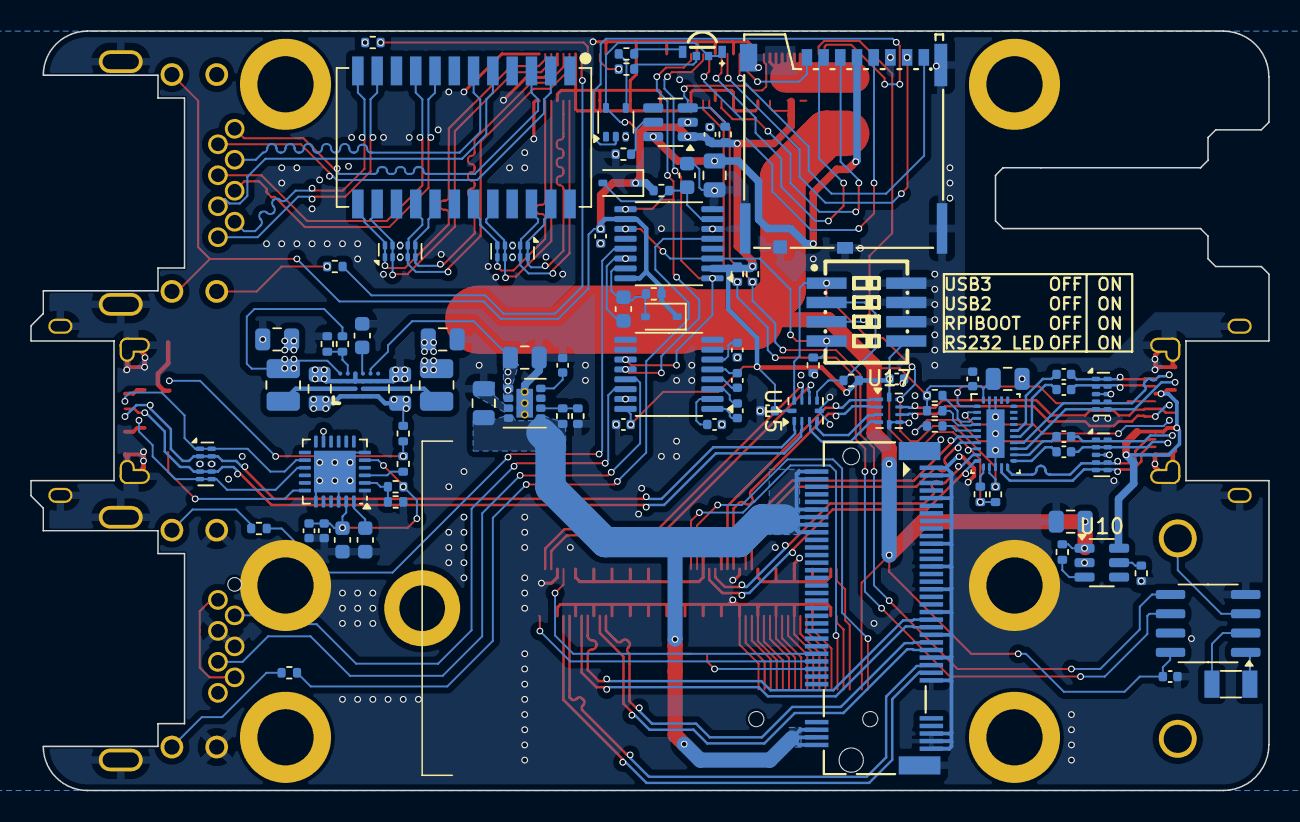
[picture p10: board PiCard.kicad_pcb from below]

Board: 4 copper layers, 81.5 x 50.0 mm, 104 parts (88 on the bottom side), 136 nets.
