weiiwang01/picard/(commit log)

2024-04-18 First prototype
    [PiCard.kicad_pcb, PiCard.kicad_sch, module_a.kicad_sch, module_b.kicad_sch]
2024-04-26 Fix ethernet wiring order
    [PiCard.kicad_pcb, module_a.kicad_sch]
2024-05-11 Clean up schematics
    [PiCard.kicad_pcb, module_a.kicad_sch, module_b.kicad_sch]
2024-05-11 Upload case design
    [PiCard-Box.step, PiCard-Lid.step]
